MarJong/FabLock/FapLock.kicad_pcb

## KiCad design FapLock.kicad_pcb (2018-01-13)

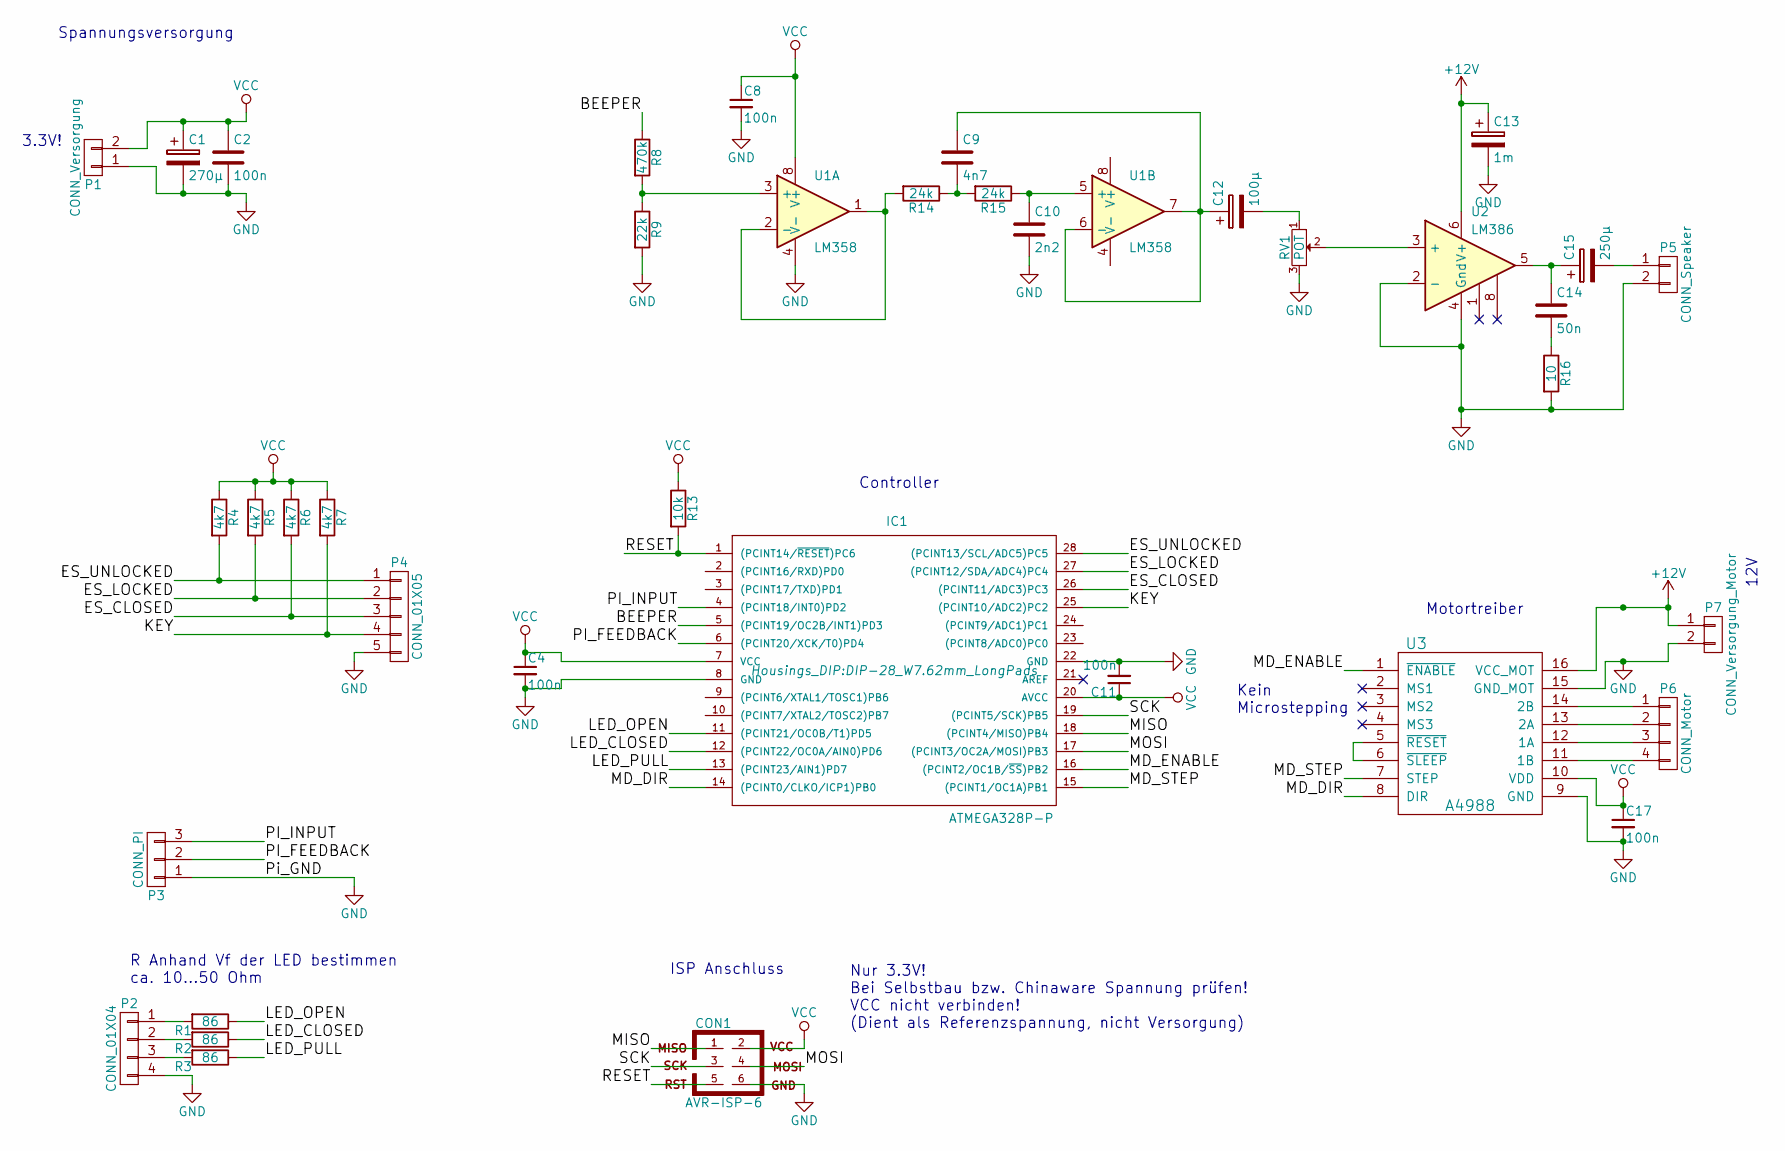
[picture p1: schematic FapLock.sch]

Parts:
C1: 270µ; C1V8
C2, C4, C8, C11, C17: 100n; C_Disc_D3_P2.5
C9: 4n7; C_Disc_D3_P2.5
C10: 2n2; C_Disc_D3_P2.5
C12: 100µ; C1V8
C13: 1m; C2V8
C14: 50n; C_Disc_D3_P2.5
C15: 250µ; C1V8
CON1: AVR-ISP-6; Pin_Header_Straight_2x03
IC1: ATMEGA328P-P; DIP-28_W7.62mm_LongPads
P1: CONN_Versorgung; Pin_Header_Straight_1x02
P2: CONN_01X04; Pin_Header_Straight_1x04
P3: CONN_PI; Pin_Header_Straight_1x03
P4: CONN_01X05; Pin_Header_Straight_1x05
P5: CONN_Speaker; Pin_Header_Straight_1x02
P6: CONN_Motor; Pin_Header_Straight_1x04
P7: CONN_Versorgung_Motor; Pin_Header_Straight_1x02
R1, R2, R3: 86; R4
R4, R5, R6, R7: 4k7; R4
R8: 470k; R4
R9: 22k; R4
R13: 10k; R4
R14, R15: 24k; R4
R16: 10; R4
RV1: POT; Potentiometer_Bourns_3339P_Angular_ScrewUp
U1: LM358; DIP-8_W7.62mm_LongPads
U2: LM386; DIP-8_W7.62mm_LongPads
U3: A4988; A4988_Pololu

Connections:
+12V: C13.1, P7.1, U2.6 (V+), U3.16 (VCC_MOT)
/BEEPER: IC1.5 ((PCINT19/OC2B/INT1)PD3), R8.1
/ES_CLOSED: IC1.26 ((PCINT11/ADC3)PC3), P4.3, R6.2
/ES_LOCKED: IC1.27 ((PCINT12/SDA/ADC4)PC4), P4.2, R5.2
/ES_UNLOCKED: IC1.28 ((PCINT13/SCL/ADC5)PC5), P4.1, R4.2
/KEY: IC1.25 ((PCINT10/ADC2)PC2), P4.4, R7.2
/LED_CLOSED: IC1.12 ((PCINT22/OC0A/AIN0)PD6), R2.1
/LED_OPEN: IC1.11 ((PCINT21/OC0B/T1)PD5), R1.1
/LED_PULL: IC1.13 ((PCINT23/AIN1)PD7), R3.1
/MD_DIR: IC1.14 ((PCINT0/CLKO/ICP1)PB0), U3.8 (DIR)
/MD_ENABLE: IC1.16 ((PCINT2/OC1B/~SS~)PB2), U3.1 (~ENABLE)
/MD_STEP: IC1.15 ((PCINT1/OC1A)PB1), U3.7 (STEP)
/MISO: CON1.1, IC1.18 ((PCINT4/MISO)PB4)
/MOSI: CON1.4, IC1.17 ((PCINT3/OC2A/MOSI)PB3)
/PI_FEEDBACK: IC1.6 ((PCINT20/XCK/T0)PD4), P3.2
/PI_INPUT: IC1.4 ((PCINT18/INT0)PD2), P3.3
/RESET: CON1.5, IC1.1 ((PCINT14/~RESET~)PC6), R13.2
/SCK: CON1.3, IC1.19 ((PCINT5/SCK)PB5)
GND: C1.2, C2.2, C4.2, C8.2, C10.2, C11.2, C13.2, C17.2, CON1.6, IC1.8 (GND), IC1.22 (GND), P1.1, P2.4, P3.1, P4.5, P5.2, P7.2, R9.2, R16.2, RV1.3, U1.4 (V-), U2.2 (-), U2.4 (Gnd), U3.9 (GND), U3.15 (GND_MOT)
unnamed: C9.2, R14.1, R15.2
unnamed: C10.1, R15.1, U1.5 (+)
unnamed: C9.1, C12.1, U1.6 (-), U1.7
unnamed: C12.2, RV1.1
unnamed: C14.1, C15.1, U2.5
unnamed: C14.2, R16.1
unnamed: C15.2, P5.1
unnamed: P2.1, R1.2
unnamed: P2.2, R2.2
unnamed: P2.3, R3.2
unnamed: P6.1, U3.14 (2B)
unnamed: P6.2, U3.13 (2A)
unnamed: P6.3, U3.12 (1A)
unnamed: P6.4, U3.11 (1B)
unnamed: R8.2, R9.1, U1.3 (+)
unnamed: R14.2, U1.1, U1.2 (-)
unnamed: RV1.2, U2.3 (+)
unnamed: U3.5 (~RESET), U3.6 (~SLEEP)
VCC: C1.1, C2.1, C4.1, C8.1, C11.1, C17.1, CON1.2, IC1.7 (VCC), IC1.20 (AVCC), P1.2, R4.1, R5.1, R6.1, R7.1, R13.1, U1.8 (V+), U3.10 (VDD)

Notes on the sheet:
3.3V!
Spannungsversorgung
ISP Anschluss
Nur 3.3V! Bei Selbstbau bzw. Chinaware Spannung prüfen! VCC nicht verbinden! (Dient als Referenzspannung, nicht Versorgung)
Motortreiber
Controller
Kein Microstepping
R Anhand Vf der LED bestimmen ca. 10...50 Ohm
12V

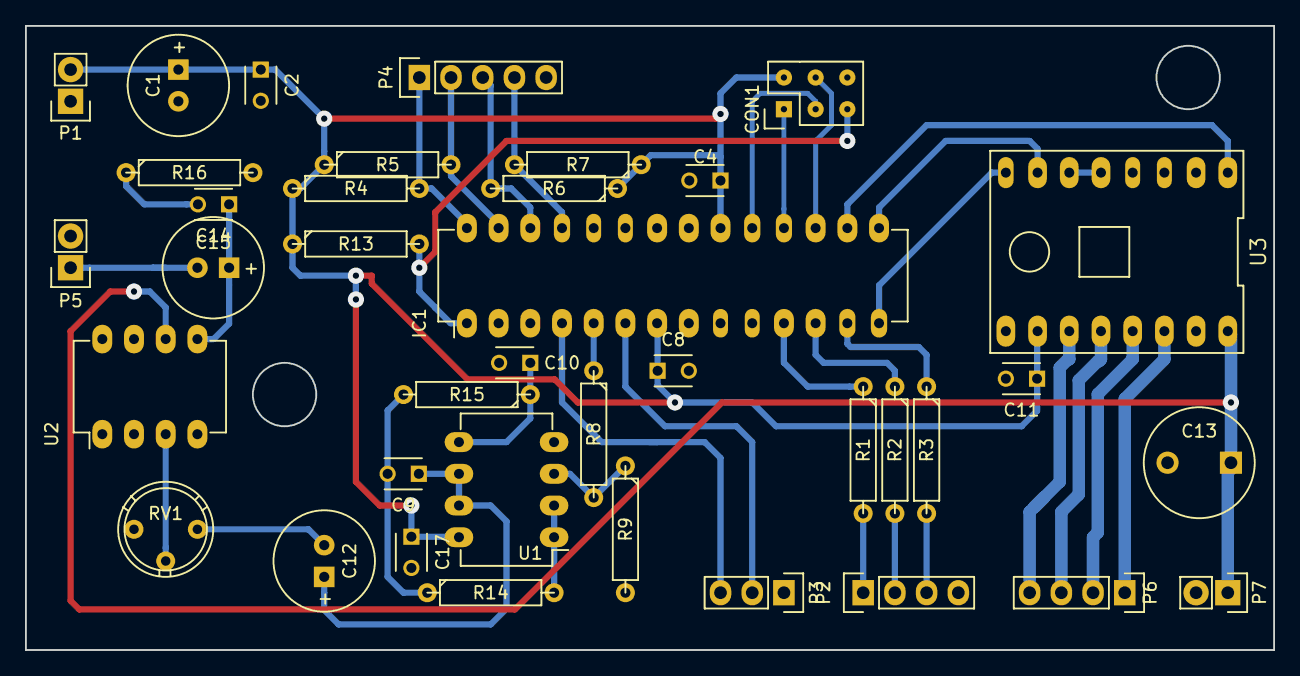
[picture p2: board FapLock.kicad_pcb from above]

Board: 2 copper layers, 100.0 x 50.0 mm, 38 parts (0 on the bottom side), 38 nets.
